se55en/Health_System/引脚接线.md

# 接线

### 红外测温

紫VCC

灰GND

白SCL

黑SDA

### 心率血氧

红 vcc-3V3

灰 模块RX-小熊派gpio11

紫 模块TX-小熊派gpio12

蓝 gnd - gnd

### 加热控制

红--gpio  13
