se55en/Health_System/使用说明.md

# 功能

测量用户温度，心率，血氧

语音打开药盒

小程序设定药盒时钟，语音播报提醒吃药

小程序设置用户身高

小程序显示用户健康指标信息

串口屏显示用户健康指标信息

体重称测量用户体重，并计算出bmi大小

药盒主控，体重称，微信小程序，华为云服务器之间互相通信

# 使用

药盒背后连接type-c供电

上电后屏幕显示日期时间，点击串口屏切换为用户健康指标页面，再次点击切换为时钟界面

食指置于心率血氧传感器上数秒后测得用户心率血氧数据

“小零小零”唤醒语音助手，说出“打开一号药盒”即可打开一号药盒，说出“关闭药盒”即可关闭药盒。打开其他药盒同理

唤醒药盒后，说出“播报我的健康指标状态”，语音播报用户健康指标状态

到达小程序设定的药盒时间后语音提醒吃药，拿取药物后，说出“我吃完了”，药盒关闭

若要使设备间互相通信，需连接热点，账号“kiss”，密码“13215008017”

体重秤用电池供电，背后拨动开关控制，可用type-c充电
