se55en/Health_System/通信协议.md

### 华为云与3861通信

### 云端下发

string：“1/09/30/00”

第一个数字：表示给第几个药盒定闹钟

09/30/00表示定闹钟的时间

#### 身高

stirng"h/175"

### 3861与32通信

string：“@1/09/30/00##”

@为包头；##为包尾

第一个数字：表示给第几个药盒定闹钟

09/30/00表示定闹钟的时间

string"@H2##"

H（HeartRate）表示心率，2表示偏高，1表示正常，0表示偏低，

O（Oxygen）表示血氧

T（Temperature）表示温度

string"@H88O99G178T25.3W74.5B18.2##"    		整数数据

string"@##"					浮点数数据

### 3861与体重秤通信

### 32与语音模块通信

吃药时间到，	32串口发送0x01，语音输出 “主人该吃药了”

体温异常，		32串口发送0x02，语音输出 “您的体温偏高”

体温异常，		32串口发送0x03，语音输出 “您的体温偏低”

bmi异常，		32串口发送0x04，语音输出 “您的体重过重”

bmi异常，		32串口发送0x05，语音输出 “您的体重偏瘦”

心率异常，		32串口发送0x06，语音输出 “您的心率偏高”

心率异常，		32串口发送0x07，语音输出 “您的心率偏低”

血氧异常，		32串口发送0x08，语音输出 “您的血氧偏低”

一切正常 ，		32串口发送0x09，语音输出 “您的健康指标一切正常”

语音接收“我吃好了”，语音模块串口发送0xa1, 32接收到关闭药盒

语音接收“播报我的健康指标状态”，语音模块串口发送0xa2, 32接收到判断健康指标

语音接收：“打开一号药盒” ，语音模块串口发送0xb1

语音接收：“打开二号药盒” ，语音模块串口发送0xb2

语音接收：“打开三号药盒” ，语音模块串口发送0xb3

语音接收：“打开四号药盒” ，语音模块串口发送0xb4

语音接收：“打开五号药盒” ，语音模块串口发送0xb5

语音接收：“打开六号药盒” ，语音模块串口发送0xb6

语音接收：“打开七号药盒” ，语音模块串口发送0xb7

语音接收：“关闭药盒” ，语音模块串口发送0xa3

语音接收：“开始加热” ，语音模块串口发送0xc1

语音接收：“停止加热” ，语音模块串口发送0xc2

## 云端下发(数据发给3861)

###  定时

 { "service_id": "Health_System", "command_name": "Medicine_Clock", "paras": { "Clock": "2/12/00/00" } }

内容为json格式， "service_id"服务id，这里为 "Health_System"；"command_name"命令名称，这里为"Medicine_Clock"； "paras"不变；"Clock"下发参数，这里为"2/12/00/00"，下定时命令时要改的是这里

string：“1/09/30/00”

第一个数字：表示给第几个药盒定闹钟

09/30/00表示定闹钟的时间

### 身高

{ "service_id": "Health_System", "command_name": "Height", "paras": { "hight": 180 } }

int类型，180表示180cm

## 3861上报(数据发给云端)

{serviceId: Health_System, data: 

{"Weight":65,"Temperature":20}}

内容为json格式，其中serviceId: Health_System, data:保持不变，上报的数据有string和int的类型

"Temperature"等为数据的名称，20为数据值，表示20°C

"Weight"，65表示65kg
