se55en/Health_System/药盒外壳/Camera enclosure top 20240318.STL

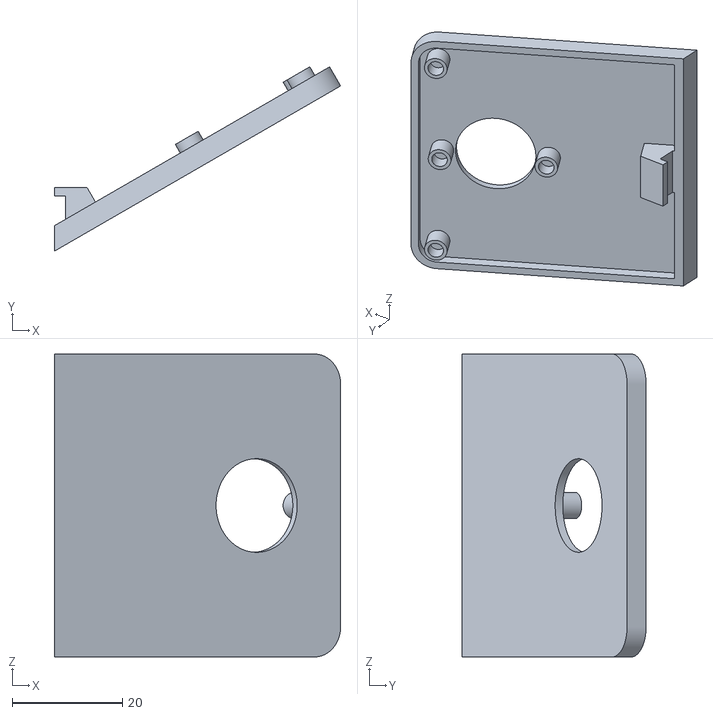
[picture p17: CAD file, 2024-09-16]
药盒外壳/Camera enclosure top 20240318.STL
52.0 x 33.5 x 55.0
