se55en/Health_System/药盒外壳/servo mount left 20240318.STL

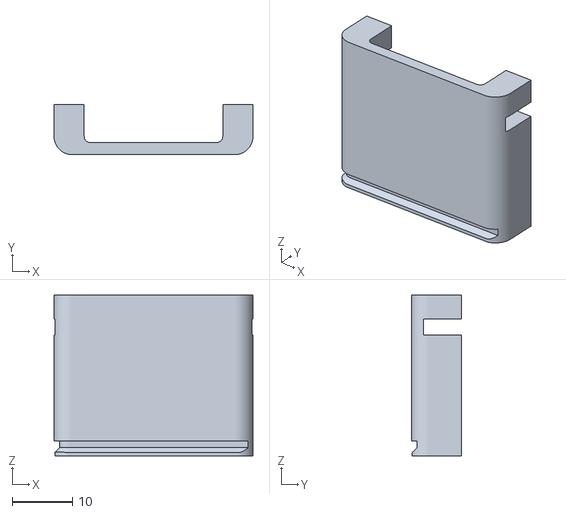
[picture p18: CAD file, 2024-09-16]
药盒外壳/servo mount left 20240318.STL
32.9 x 8.30 x 26.6
