se55en/Health_System/药盒外壳/Camera enclosure bottom 20240322.STL

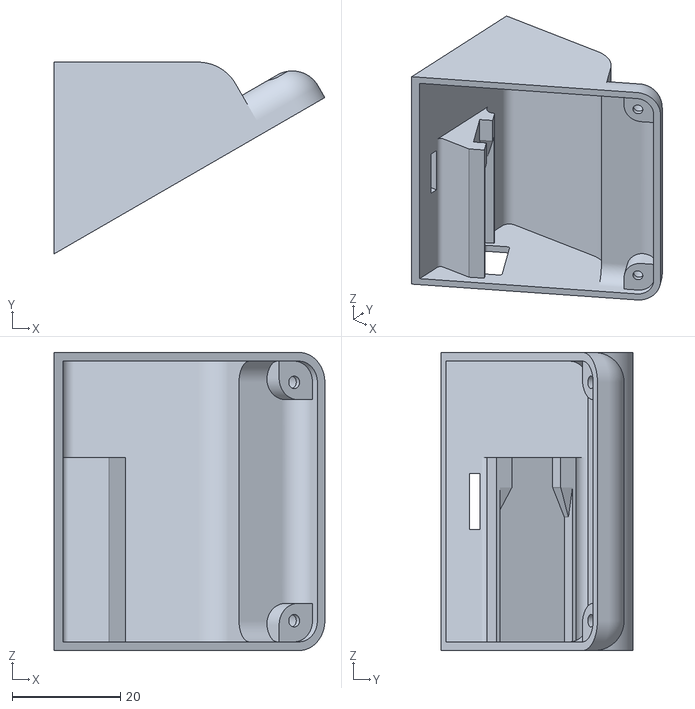
[picture p19: CAD file, 2024-09-16]
药盒外壳/Camera enclosure bottom 20240322.STL
50.0 x 35.4 x 55.0
