se55en/Health_System/药盒外壳/dock 20240322.STL

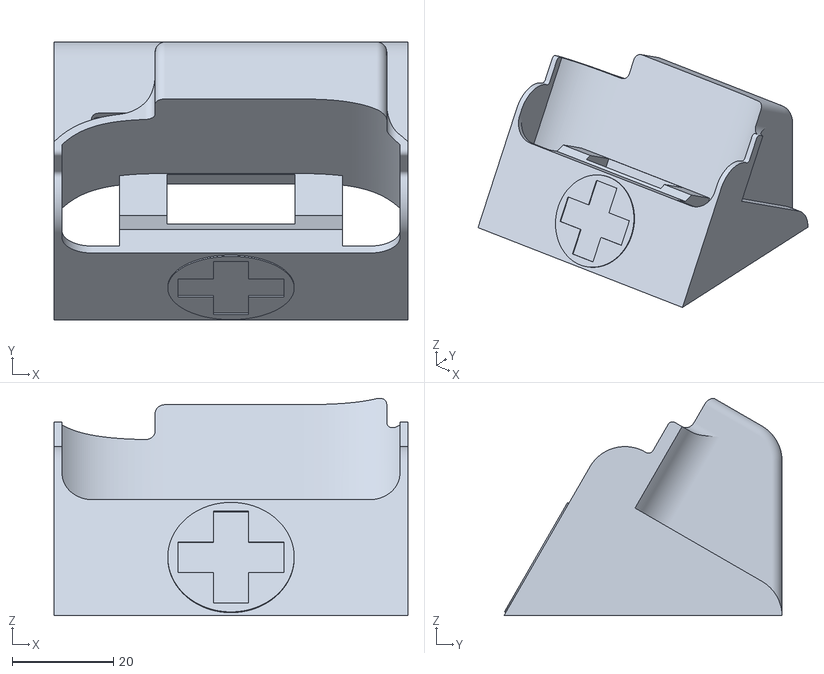
[picture p20: CAD file, 2024-09-16]
药盒外壳/dock 20240322.STL
70.0 x 55.0 x 43.0
