se55en/Health_System/药盒外壳/scan cover.STL

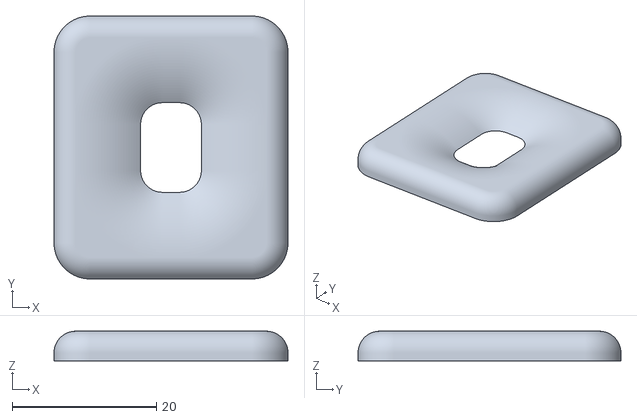
[picture p21: CAD file, 2024-09-16]
药盒外壳/scan cover.STL
32.4 x 36.4 x 4.10
