se55en/Health_System/药盒外壳/top 20240322.STL

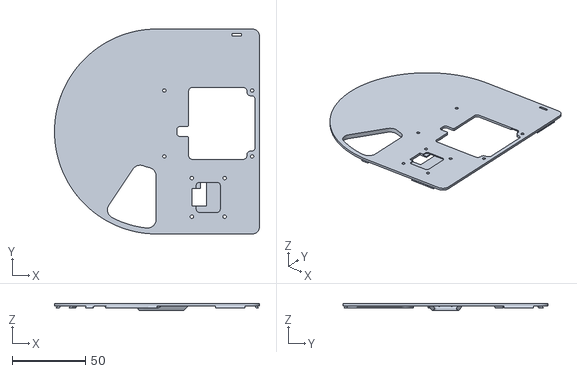
[picture p22: CAD file, 2024-09-16]
药盒外壳/top 20240322.STL
140.0 x 140.0 x 4.80
