se55en/Health_System/药盒外壳/Lock arm 20240318.STL

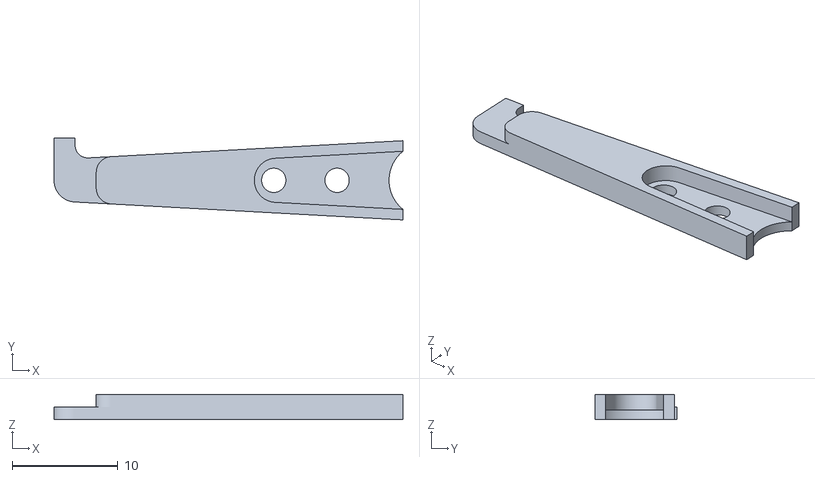
[picture p23: CAD file, 2024-09-16]
药盒外壳/Lock arm 20240318.STL
33.1 x 7.75 x 2.40
