se55en/Health_System/(list of files, cad)

Other CAD files:
药盒外壳/servo mount right 20240318.STL
