se55en/Health_System/(list of files, drawings)

Other design files:
32接插板/32接插板/32接插板.eprj
