se55en/Health_System/hi3861程序/src/oc_mqtt.c

/*----------------------------------------------------------------------------
 * Copyright (c) <2018>, <Huawei Technologies Co., Ltd>
 * All rights reserved.
 * Redistribution and use in source and binary forms, with or without modification,
 * are permitted provided that the following conditions are met:
 * 1. Redistributions of source code must retain the above copyright notice, this list of
 * conditions and the following disclaimer.
 * 2. Redistributions in binary form must reproduce the above copyright notice, this list
 * of conditions and the following disclaimer in the documentation and/or other materials
 * provided with the distribution.
 * 3. Neither the name of the copyright holder nor the names of its contributors may be used
 * to endorse or promote products derived from this software without specific prior written
 * permission.
 * THIS SOFTWARE IS PROVIDED BY THE COPYRIGHT HOLDERS AND CONTRIBUTORS
 * "AS IS" AND ANY EXPRESS OR IMPLIED WARRANTIES, INCLUDING, BUT NOT LIMITED TO,
 * THE IMPLIED WARRANTIES OF MERCHANTABILITY AND FITNESS FOR A PARTICULAR
 * PURPOSE ARE DISCLAIMED. IN NO EVENT SHALL THE COPYRIGHT HOLDER OR
 * CONTRIBUTORS BE LIABLE FOR ANY DIRECT, INDIRECT, INCIDENTAL, SPECIAL,
 * EXEMPLARY, OR CONSEQUENTIAL DAMAGES (INCLUDING, BUT NOT LIMITED TO,
 * PROCUREMENT OF SUBSTITUTE GOODS OR SERVICES; LOSS OF USE, DATA, OR PROFITS;
 * OR BUSINESS INTERRUPTION) HOWEVER CAUSED AND ON ANY THEORY OF LIABILITY,
 * WHETHER IN CONTRACT, STRICT LIABILITY, OR TORT (INCLUDING NEGLIGENCE OR
 * OTHERWISE) ARISING IN ANY WAY OUT OF THE USE OF THIS SOFTWARE, EVEN IF
 * ADVISED OF THE POSSIBILITY OF SUCH DAMAGE.
 *---------------------------------------------------------------------------*/
 /*----------------------------------------------------------------------------
  * Notice of Export Control Law
  * ===============================================
  * Huawei LiteOS may be subject to applicable export control laws and regulations, which might
  * include those applicable to Huawei LiteOS of U.S. and the country in which you are located.
  * Import, export and usage of Huawei LiteOS in any manner by you shall be in compliance with such
  * applicable export control laws and regulations.
  *---------------------------------------------------------------------------*/
  /**
   *  DATE                AUTHOR      INSTRUCTION
   *  2020-02-05 17:00  zhangqianfu  The first version
   *
   */


#include <stdio.h>
#include <string.h>
#include <unistd.h>

#include "cJSON.h"
#include "cmsis_os2.h"
#include "MQTTClient.h"

#include <oc_mqtt.h>
#include <oc_mqtt_profile_package.h>


#define OC_MQTT_CONSTANT_1          6
#define OC_MQTT_BUF_SIZE            2048
#define OS_MQTT_CMD_TIMEOUT         1000
#define OS_MQTT_KEEP_ALIVE          30
#define OS_MQTT_VERSION             3

typedef struct {
    char *device_id;
    fn_oc_mqtt_profile_rcvdeal rcvfunc;
} oc_mqtt_profile_cb_t;

static oc_mqtt_profile_cb_t s_oc_mqtt_profile_cb;

static char init_ok = FALSE;
static MQTTClient mq_client;
struct bp_oc_info oc_info;
struct oc_device {
    struct bp_oc_info *oc_info;

    void (*cmd_rsp_cb)(uint8_t *recv_data, size_t recv_size, uint8_t **resp_data, size_t *resp_size);
} oc_mqtt;

void mqtt_callback(MessageData *msg_data)
{
    // size_t res_len = 0;
    // uint8_t *response_buf = NULL;
    // char topicname[45] = { "1" };

    // char* topic = Topic_Back;
    
    // LOS_ASSERT(topic);
    // LOS_ASSERT(msg_data);
    
    // printf("topic %.*s receive a message", msg_data->topicName->lenstring.len, msg_data->topicName->lenstring.data);
    // printf("message length is %d", msg_data->message->payloadlen);

    // if (oc_mqtt.cmd_rsp_cb != NULL) {
    //     oc_mqtt.cmd_rsp_cb((uint8_t *)msg_data->message->payload, msg_data->message->payloadlen, &response_buf,
    //         &res_len);

    //     if (response_buf != NULL || res_len != 0) {
    //         strncat_s(topicname, sizeof(topicname), &(msg_data->topicName->lenstring.data[OC_MQTT_CONSTANT_1]),
    //         msg_data->topicName->lenstring.len - OC_MQTT_CONSTANT_1);

    //         oc_mqtt_publish(topicname, response_buf, strlen((const char *)response_buf), (int)en_mqtt_al_qos_1);

    //         free(response_buf);
    //     }
    // }
}
unsigned char *oc_mqtt_buf;
unsigned char *oc_mqtt_readbuf;
int buf_size;

Network n;
MQTTPacket_connectData data = MQTTPacket_connectData_initializer;
uint8_t recv_flag = 0;
char recv_data[512];
void messageArrived(MessageData *data)
{
    recv_flag = 1;
    printf("Message arrived on topic %.*s: %.*s\n", data->topicName->lenstring.len,
        data->topicName->lenstring.data, data->message->payloadlen, data->message->payload);
    strcpy(recv_data,data->message->payload);
    strncpy_s(recv_data, strlen(recv_data)+1, data->message->payload, data->message->payloadlen);
}

int oc_mqtt_entry(void)
{
    int rc = 0;

    NetworkInit(&n);
    NetworkConnect(&n, OC_SERVER_IP, OC_SERVER_PORT);

    buf_size = OC_MQTT_BUF_SIZE;
    oc_mqtt_buf = (unsigned char *)malloc(buf_size);
    oc_mqtt_readbuf = (unsigned char *)malloc(buf_size);
    if (!(oc_mqtt_buf && oc_mqtt_readbuf)) {
        printf("No memory for MQTT client buffer!");
        return -1;
    }

    MQTTClientInit(&mq_client, &n, OS_MQTT_CMD_TIMEOUT, oc_mqtt_buf, buf_size, oc_mqtt_readbuf, buf_size);

    MQTTStartTask(&mq_client);

    data.keepAliveInterval = OS_MQTT_KEEP_ALIVE;
    data.cleansession = 1;
    data.clientID.cstring = oc_info.client_id;
    data.username.cstring = oc_info.username;
    data.password.cstring = oc_info.password;
    data.MQTTVersion = OS_MQTT_VERSION;

    mq_client.defaultMessageHandler = mqtt_callback;

    rc = MQTTConnect(&mq_client, &data);

    printf("MQTTSubscribe  ...\n");
    rc = MQTTSubscribe(&mq_client, Topic_Back, 0, messageArrived);//订阅消息，参数4，收到消息的回调函数，对消息处理
    if (rc != 0) {
        printf("MQTTSubscribe: %d\n", rc);
        osDelay(200);
    }
    rc = MQTTSubscribe(&mq_client, Topic_Weight, 0, messageArrived);//订阅消息，参数4，收到消息的回调函数，对消息处理
    if (rc != 0) {
        printf("MQTTSubscribe: %d\n", rc);
        osDelay(200);
    }
    return rc;
}

void device_info_init(char *client_id, char *username, char *password)
{
    oc_info.user_device_id_flg = 1;
    strncpy_s(oc_info.client_id, strlen(client_id)+1, client_id, strlen(client_id));
    strncpy_s(oc_info.username, strlen(username)+1, username, strlen(username));
    strncpy_s(oc_info.password, strlen(password)+1, password, strlen(password));
}

/**
 * oc mqtt client init.
 *
 * @param   NULL
 *
 * @return  0 : init success
 *         -1 : init fail
 */
// int oc_mqtt_init(void)
// {
//     int result = 0;

//     if (init_ok) {
//         return 0;
//     }
//     if (oc_mqtt_entry() < 0) {
//         result = -1;
//         if (!result) {
//             init_ok = 0;
//         }
//         return result;
//     }

//     return result;
// }
/**
 * set the command responses call back function
 *
 * @param   cmd_rsp_cb  command responses call back function
 *
 * @return  0 : set success
 *         -1 : function is null
 */
void oc_set_cmd_rsp_cb(
    void (*cmd_rsp_cb)(uint8_t *recv_data, uint32_t recv_size, uint8_t **resp_data, uint32_t *resp_size))
{
    oc_mqtt.cmd_rsp_cb = cmd_rsp_cb;
}

/**
 * mqtt publish msg to topic
 *
 * @param   topic   target topic
 * @param   msg     message to be sent
 * @param   len     message length
 *
 * @return  0 : publish success
 *         -1 : publish fail
 */
int oc_mqtt_publish(char *topic, uint8_t *msg, int msg_len, int qos)
{
    MQTTMessage message;

    LOS_ASSERT(topic);
    LOS_ASSERT(msg);

    message.qos = qos;
    message.retained = 0;
    message.payload = (void *)msg;
    message.payloadlen = msg_len;
    if (MQTTPublish(&mq_client, topic, &message) < 0) {
        return -1;
    }

    return 0;
}
///< use this function to make a topic to publish
///< if request_id  is needed depends on the fmt
static char *topic_make(char *fmt, char *device_id, char *request_id)
{
    int len;
    char *ret = NULL;

    if (device_id == NULL) {
        return ret;
    }
    len = strlen(fmt) + strlen(device_id);
    if (request_id != NULL) {
        len += strlen(request_id);
    }

    ret = malloc(len);
    if (ret != NULL) {
        (void)snprintf_s(ret, len, len, fmt, device_id, request_id);
    }
    return ret;
}

///< use this function to report the messsage
#define CN_OC_MQTT_PROFILE_MSGUP_TOPICFMT "$oc/devices/%s/sys/messages/up"
int oc_mqtt_profile_msgup(char *deviceid, oc_mqtt_profile_msgup_t *payload)
{
    int ret = (int)en_oc_mqtt_err_parafmt;
    char *topic;
    char *msg;
    char *device_id = deviceid;

    if (device_id == NULL) {
        if (s_oc_mqtt_profile_cb.device_id == NULL) {
            return ret;
        } else {
            device_id = s_oc_mqtt_profile_cb.device_id;
        }
    }

    if ((payload == NULL) || (payload->msg == NULL)) {
        return ret;
    }

    topic = topic_make(CN_OC_MQTT_PROFILE_MSGUP_TOPICFMT, device_id, NULL);
    msg = oc_mqtt_profile_package_msgup(payload);
    if ((topic != NULL) && (msg != NULL)) {
        ret = oc_mqtt_publish(topic, (uint8_t *)msg, strlen(msg), (int)en_mqtt_al_qos_1);
    } else {
        ret = (int)en_oc_mqtt_err_sysmem;
    }

    free(topic);
    free(msg);

    return ret;
}

//#define CN_OC_MQTT_PROFILE_PROPERTYREPORT_TOPICFMT "$oc/devices/%s/sys/properties/report"
#define CN_OC_MQTT_PROFILE_PROPERTYREPORT_TOPICFMT Topic_Data
int oc_mqtt_profile_propertyreport(char *deviceid, oc_mqtt_profile_service_t *payload)
{
    int ret = (int)en_oc_mqtt_err_parafmt;
    char *topic;
    char *msg;
    char *device_id = deviceid;
    
    if (device_id == NULL) {
        if (s_oc_mqtt_profile_cb.device_id == NULL) {
            return ret;
        } else {
            device_id = s_oc_mqtt_profile_cb.device_id;
        }
    }

    if ((payload == NULL) || (payload->service_id == NULL) || (payload->service_property == NULL)) {
        return ret;
    }

    topic = topic_make(CN_OC_MQTT_PROFILE_PROPERTYREPORT_TOPICFMT, device_id, NULL);
    printf("topic:%s\n",topic);
    msg = oc_mqtt_profile_package_propertyreport(payload);
    if ((topic != NULL) && (msg != NULL)) {
        ret = oc_mqtt_publish(topic, (uint8_t *)msg, strlen(msg), (int)en_mqtt_al_qos_1);
    } else {
        ret = (int)en_oc_mqtt_err_sysmem;
    }

    free(topic);
    free(msg);

    return ret;
}

#define CN_OC_MQTT_PROFILE_GWPROPERTYREPORT_TOPICFMT "$oc/devices/%s/sys/gateway/sub_devices/properties/report"
int oc_mqtt_profile_gwpropertyreport(char *deviceid, oc_mqtt_profile_device_t *payload)
{
    int ret = (int)en_oc_mqtt_err_parafmt;
    char *topic;
    char *msg;
    char *device_id = deviceid;

    if (device_id == NULL) {
        if (s_oc_mqtt_profile_cb.device_id == NULL) {
            return ret;
        } else {
            device_id = s_oc_mqtt_profile_cb.device_id;
        }
    }

    if ((payload == NULL) || (payload->subdevice_id == NULL) || (payload->subdevice_property == NULL) ||
        (payload->subdevice_property->service_id == NULL) || (payload->subdevice_property->service_property == NULL)) {
        return ret;
    }

    topic = topic_make(CN_OC_MQTT_PROFILE_GWPROPERTYREPORT_TOPICFMT, device_id, NULL);
    msg = oc_mqtt_profile_package_gwpropertyreport(payload);
    if ((topic != NULL) && (msg != NULL)) {
        ret = oc_mqtt_publish(topic, (uint8_t *)msg, strlen(msg), (int)en_mqtt_al_qos_1);
    } else {
        ret = (int)en_oc_mqtt_err_sysmem;
    }

    free(topic);
    free(msg);

    return ret;
}

#define CN_OC_MQTT_PROFILE_ROPERTYSETRESP_TOPICFMT "$oc/devices/%s/sys/properties/set/response/request_id=%s"
int oc_mqtt_profile_propertysetresp(char *deviceid, oc_mqtt_profile_propertysetresp_t *payload)
{
    int ret = (int)en_oc_mqtt_err_parafmt;
    char *topic;
    char *msg;
    char *device_id = deviceid;

    if (device_id == NULL) {
        if (s_oc_mqtt_profile_cb.device_id == NULL) {
            return ret;
        } else {
            device_id = s_oc_mqtt_profile_cb.device_id;
        }
    }

    if ((payload == NULL) || (payload->request_id == NULL)) {
        return ret;
    }
    topic = topic_make(CN_OC_MQTT_PROFILE_ROPERTYSETRESP_TOPICFMT, device_id, payload->request_id);
    msg = oc_mqtt_profile_package_propertysetresp(payload);
    if ((topic != NULL) && (msg != NULL)) {
        ret = oc_mqtt_publish(topic, (uint8_t *)msg, strlen(msg), (int)en_mqtt_al_qos_1);
    } else {
        ret = (int)en_oc_mqtt_err_sysmem;
    }

    free(topic);
    free(msg);

    return ret;
}

#define CN_OC_MQTT_PROFILE_ROPERTYGETRESP_TOPICFMT "$oc/devices/%s/sys/properties/get/response/request_id=%s"
int oc_mqtt_profile_propertygetresp(char *deviceid, oc_mqtt_profile_propertygetresp_t *payload)
{
    int ret = (int)en_oc_mqtt_err_parafmt;
    char *topic;
    char *msg;
    char *device_id = deviceid;

    if (device_id == NULL) {
        if (s_oc_mqtt_profile_cb.device_id == NULL) {
            return ret;
        } else {
            device_id = s_oc_mqtt_profile_cb.device_id;
        }
    }

    if ((payload == NULL) || (payload->request_id == NULL) || (payload->services->service_id == NULL) ||
        (payload->services->service_property == NULL)) {
        return ret;
    }

    topic = topic_make(CN_OC_MQTT_PROFILE_ROPERTYGETRESP_TOPICFMT, device_id, payload->request_id);
    msg = oc_mqtt_profile_package_propertygetresp(payload);
    if ((topic != NULL) && (msg != NULL)) {
        ret = oc_mqtt_publish(topic, (uint8_t *)msg, strlen(msg), (int)en_mqtt_al_qos_1);
    } else {
        ret = (int)en_oc_mqtt_err_sysmem;
    }

    free(topic);
    free(msg);

    return ret;
}

#define CN_OC_MQTT_PROFILE_CMDRESP_TOPICFMT "$oc/devices/%s/sys/commands/response/request_id=%s"
int oc_mqtt_profile_cmdresp(char *deviceid, oc_mqtt_profile_cmdresp_t *payload)
{
    int ret = (int)en_oc_mqtt_err_parafmt;
    char *topic;
    char *msg;
    char *device_id = deviceid;

    if (device_id == NULL) {
        if (s_oc_mqtt_profile_cb.device_id == NULL) {
            return ret;
        } else {
            device_id = s_oc_mqtt_profile_cb.device_id;
        }
    }

    if ((payload == NULL) || (payload->request_id == NULL)) {
        return ret;
    }

    topic = topic_make(CN_OC_MQTT_PROFILE_CMDRESP_TOPICFMT, device_id, payload->request_id);
    msg = oc_mqtt_profile_package_cmdresp(payload);
    if ((topic != NULL) && (msg != NULL)) {
        ret = oc_mqtt_publish(topic, (uint8_t *)msg, strlen(msg), (int)en_mqtt_al_qos_1);
    } else {
        ret = (int)en_oc_mqtt_err_sysmem;
    }

    free(topic);
    free(msg);

    return ret;
}
