se55en/Health_System/32程序/System/Serial.c

#include "stm32f10x.h"                  // Device header
#include "stdio.h"
uint8_t Serial_RxFlag = 0;

void Serial_Init(void)
{
	//开启usart1时钟
	RCC_APB2PeriphClockCmd(RCC_APB2Periph_USART1, ENABLE);
	//开启usart2时钟
	RCC_APB1PeriphClockCmd(RCC_APB1Periph_USART2, ENABLE);
	//开启开启usart2时钟
	RCC_APB1PeriphClockCmd(RCC_APB1Periph_USART3, ENABLE);
	//开启gpioA和B时钟
	RCC_APB2PeriphClockCmd(RCC_APB2Periph_GPIOA, ENABLE);
	RCC_APB2PeriphClockCmd(RCC_APB2Periph_GPIOB, ENABLE);
	//配置PA9-USART1-TX
	GPIO_InitTypeDef GPIO_InitStructure;
	GPIO_InitStructure.GPIO_Mode = GPIO_Mode_AF_PP;
	GPIO_InitStructure.GPIO_Pin = GPIO_Pin_9;
	GPIO_InitStructure.GPIO_Speed = GPIO_Speed_50MHz;
	GPIO_Init(GPIOA, &GPIO_InitStructure);
	//配置PA10-USART1-RX
	GPIO_InitStructure.GPIO_Mode = GPIO_Mode_IPU;
	GPIO_InitStructure.GPIO_Pin = GPIO_Pin_10;
	GPIO_Init(GPIOA, &GPIO_InitStructure);
	//配置PA2-USART2-TX
	GPIO_InitStructure.GPIO_Mode = GPIO_Mode_AF_PP;
	GPIO_InitStructure.GPIO_Pin = GPIO_Pin_2;
	GPIO_Init(GPIOA, &GPIO_InitStructure);
	//配置PA3-USART2-RX
	GPIO_InitStructure.GPIO_Mode = GPIO_Mode_IPU;
	GPIO_InitStructure.GPIO_Pin = GPIO_Pin_3;
	GPIO_Init(GPIOA, &GPIO_InitStructure);
	//配置PB10-USART3-TX
	GPIO_InitStructure.GPIO_Mode = GPIO_Mode_AF_PP;
	GPIO_InitStructure.GPIO_Pin = GPIO_Pin_10;
	GPIO_Init(GPIOB, &GPIO_InitStructure);
	//配置PB11-USART3-RX
	GPIO_InitStructure.GPIO_Mode = GPIO_Mode_IPU;
	GPIO_InitStructure.GPIO_Pin = GPIO_Pin_11;
	GPIO_Init(GPIOB, &GPIO_InitStructure);
	//配置USART1
	USART_InitTypeDef USART_InitStructure;
	USART_InitStructure.USART_BaudRate = 9600;
	USART_InitStructure.USART_HardwareFlowControl = USART_HardwareFlowControl_None;
	USART_InitStructure.USART_Mode = USART_Mode_Tx | USART_Mode_Rx;
	USART_InitStructure.USART_Parity = USART_Parity_No;
	USART_InitStructure.USART_StopBits = USART_StopBits_1;
	USART_InitStructure.USART_WordLength = USART_WordLength_8b;
	USART_Init(USART1, &USART_InitStructure);
	//配置USART2
	USART_Init(USART2, &USART_InitStructure);
	//配置USART3
	USART_InitStructure.USART_BaudRate = 115200;
	USART_Init(USART3, &USART_InitStructure);
	//配置中断
	USART_ITConfig(USART1, USART_IT_RXNE, ENABLE);
	USART_ITConfig(USART2, USART_IT_RXNE, ENABLE);
	NVIC_PriorityGroupConfig(NVIC_PriorityGroup_2);
	//USART1中断
	NVIC_InitTypeDef NVIC_InitStructure;
	NVIC_InitStructure.NVIC_IRQChannel = USART1_IRQn;
	NVIC_InitStructure.NVIC_IRQChannelCmd = ENABLE;
	NVIC_InitStructure.NVIC_IRQChannelPreemptionPriority = 1;
	NVIC_InitStructure.NVIC_IRQChannelSubPriority = 1;
	NVIC_Init(&NVIC_InitStructure);
	//USART2中断
	NVIC_InitStructure.NVIC_IRQChannel = USART2_IRQn;
	NVIC_InitStructure.NVIC_IRQChannelCmd = ENABLE;
	NVIC_InitStructure.NVIC_IRQChannelPreemptionPriority = 1;
	NVIC_InitStructure.NVIC_IRQChannelSubPriority = 1;
	NVIC_Init(&NVIC_InitStructure);
	//开启串口
	USART_Cmd(USART1, ENABLE);
	USART_Cmd(USART2, ENABLE);
	USART_Cmd(USART3, ENABLE);
}

void Serial_USART1_SendByte(uint8_t Byte)
{
	USART_SendData(USART1, Byte);
	while(USART_GetFlagStatus(USART1, USART_FLAG_TXE) == RESET);
}
void Serial_USART2_SendByte(uint8_t Byte)
{
	USART_SendData(USART2, Byte);
	while(USART_GetFlagStatus(USART2, USART_FLAG_TXE) == RESET);
}
void Serial_USART3_SendByte(uint8_t Byte)
{
	USART_SendData(USART3, Byte);
	while(USART_GetFlagStatus(USART3, USART_FLAG_TXE) == RESET);
}
int fputc(int ch, FILE *f)
{
	Serial_USART3_SendByte(ch);
	return ch;
}
