se55en/Health_System/32程序/System/PWM.c

#include "stm32f10x.h"                  // Device header

void PWM_Init(void)
{
	//打开APB1时钟
	RCC_APB1PeriphClockCmd(RCC_APB1Periph_TIM2, ENABLE);
	//打开APB2时钟
	RCC_APB2PeriphClockCmd(RCC_APB2Periph_GPIOA, ENABLE);
	//配置PA1
	GPIO_InitTypeDef GPIO_InitStructure;
	GPIO_InitStructure.GPIO_Mode = GPIO_Mode_AF_PP;
	GPIO_InitStructure.GPIO_Pin = GPIO_Pin_1;
	GPIO_InitStructure.GPIO_Speed = GPIO_Speed_50MHz;
	GPIO_Init(GPIOA, &GPIO_InitStructure);
	//选择内部时钟
	TIM_InternalClockConfig(TIM2);
	//初始化时基单元
	TIM_TimeBaseInitTypeDef TIM_TimeBaseInitStructure;
	TIM_TimeBaseInitStructure.TIM_ClockDivision = TIM_CKD_DIV1;
	TIM_TimeBaseInitStructure.TIM_CounterMode = TIM_CounterMode_Up;
	TIM_TimeBaseInitStructure.TIM_Period = 20000 - 1;						//ARR
	TIM_TimeBaseInitStructure.TIM_Prescaler = 72 - 1;					//PSC
	TIM_TimeBaseInitStructure.TIM_RepetitionCounter = 0;
	TIM_TimeBaseInit(TIM2, &TIM_TimeBaseInitStructure);
	//初始化输出比较单元
	TIM_OCInitTypeDef TIM_OCInitStructure;
	TIM_OCStructInit(&TIM_OCInitStructure);//将结构体初始化，避免没用到的成员影响结果
	TIM_OCInitStructure.TIM_OCMode = TIM_OCMode_PWM1;
	TIM_OCInitStructure.TIM_OCPolarity = TIM_OCPolarity_High;
	TIM_OCInitStructure.TIM_OutputState = TIM_OutputState_Enable;
	TIM_OCInitStructure.TIM_Pulse = 0;									//CCR
	TIM_OC2Init(TIM2, &TIM_OCInitStructure);
	
	TIM_Cmd(TIM2, ENABLE);
}	
void PWM_SetCompare2(uint16_t Compare)
{
	TIM_SetCompare2(TIM2,Compare);
}
