se55en/Health_System/(commit log)

2024-09-13 first submission
    [32接插板.eprj]
2024-09-16 remove zip pack
    [Camera enclosure bottom 20240322.STL, Camera enclosure top 20240318.STL, Lock arm 20240318.STL, dock 20240322.STL, scan cover.STL, servo mount left 20240318.STL, servo mount right 20240318.STL, top 20240322.STL]
2025-02-28 增加hi3861程序
